narodo/wordclock/face/word_clock_face.pdf

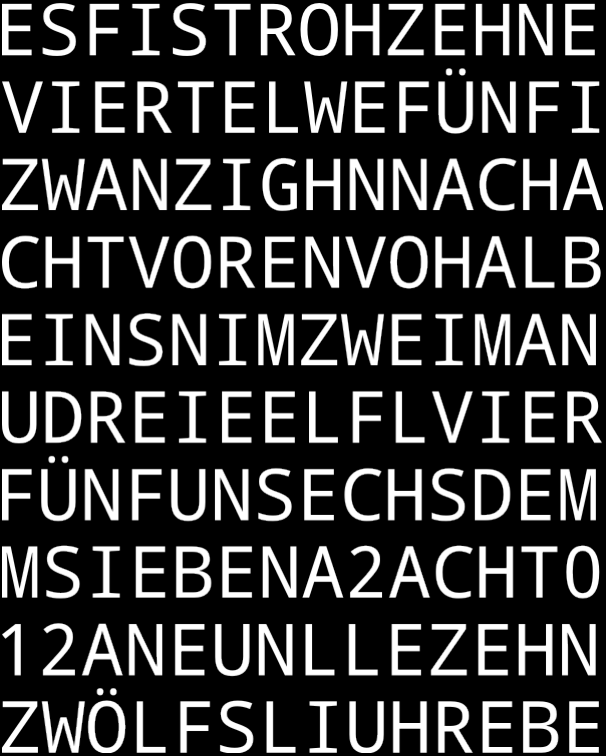
[picture p1: figure]
