narodo/wordclock/face/word_clock_face_template.pdf

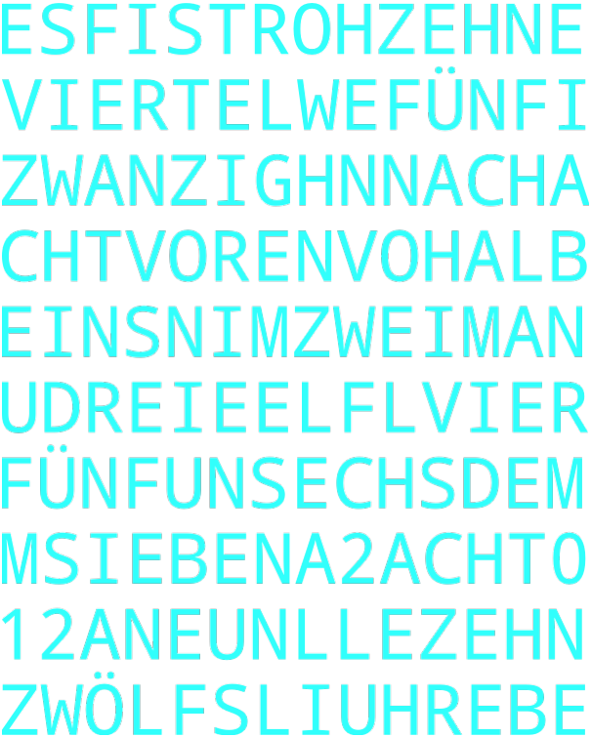
[picture p2: figure]
