narodo/wordclock/face/word_clock_face_colored.pdf

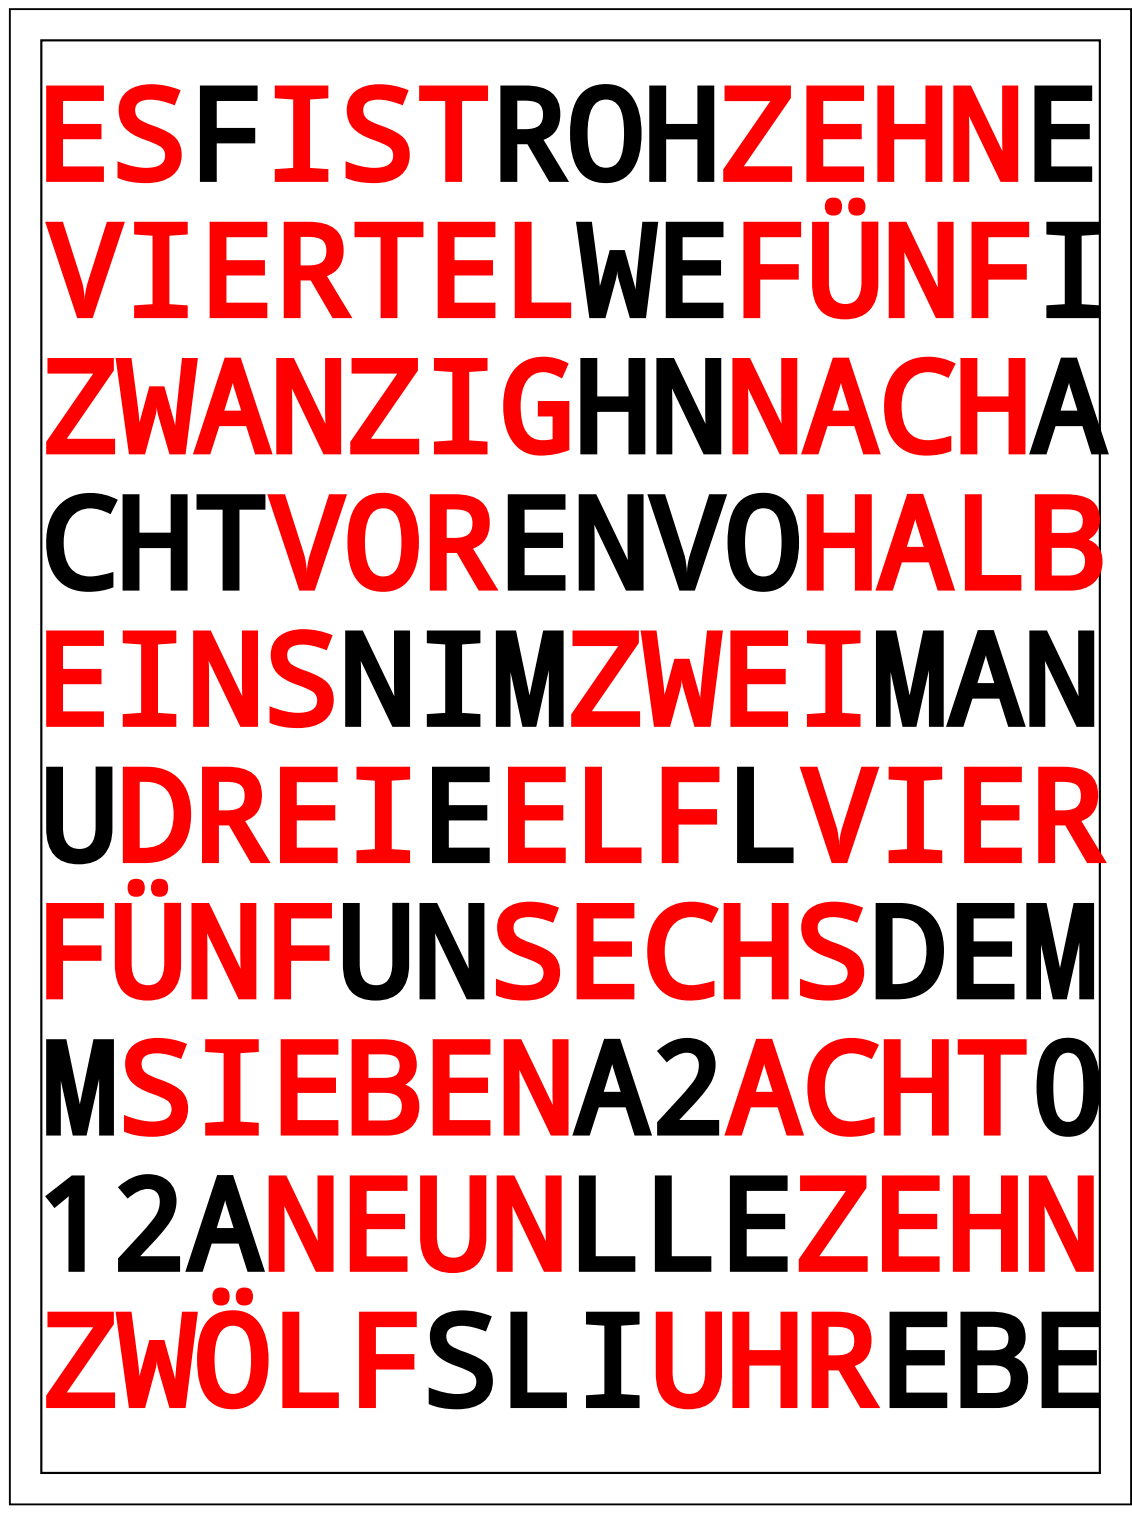
[picture p3: page 1]
