narodo/wordclock/face/word_clock_face_inverted.pdf

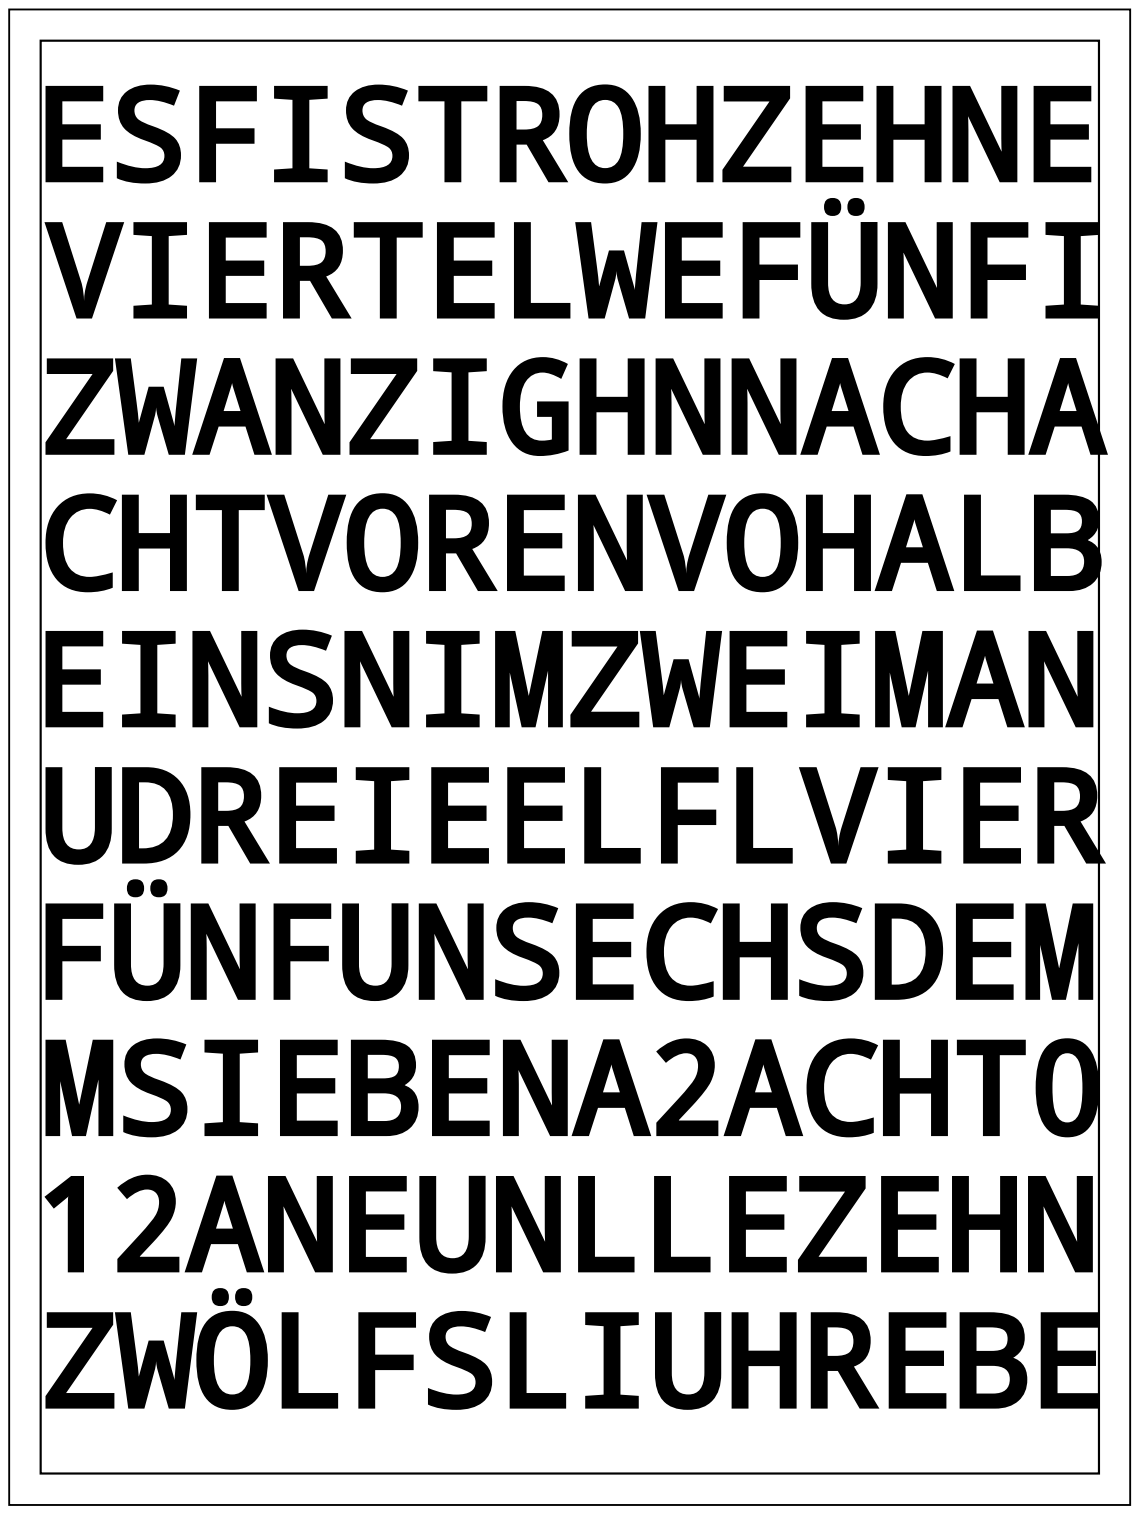
[picture p4: page 1]
