narodo/wordclock/sim/current_mirror/current_mirror.asc

D1: LED; AOT-2015
D2: LED; AOT-2015
D3: LED; AOT-2015
D4: LED; AOT-2015
D5: LED; AOT-2015
D6: LED; AOT-2015
M1: pmos; BSS84
Q1: npn; BC847C
Q2: npn; BC847C
Q3: npn; BC847C
Q4: npn; BC847C
R1: res; 700
R2: res; 100
V1: voltage; 12
V2: voltage; 0
Named nets: 0, VCC, Q4_E
.op
