narodo/wordclock/sim/current_mirror/current_mirror_pmos.asc

D1: LED; AOT-2015
D2: LED; AOT-2015
D3: LED; AOT-2015
D4: LED; AOT-2015
D5: LED; AOT-2015
D6: LED; AOT-2015
D7: LED; AOT-2015
M1: pmos; BSS84
M2: pmos; BSS84
M3: pmos; BSS84
M4: pmos; BSS84
Q1: npn
R1: res; 430
R2: res; 10000
V1: voltage; 12
V2: voltage; 5
Named nets: 0, D1_A, Q1_C
.op
