narodo/wordclock/pcb/word_clock/word_clock.sch

## KiCad design pcb/word_clock/word_clock.sch (2013-01-18)

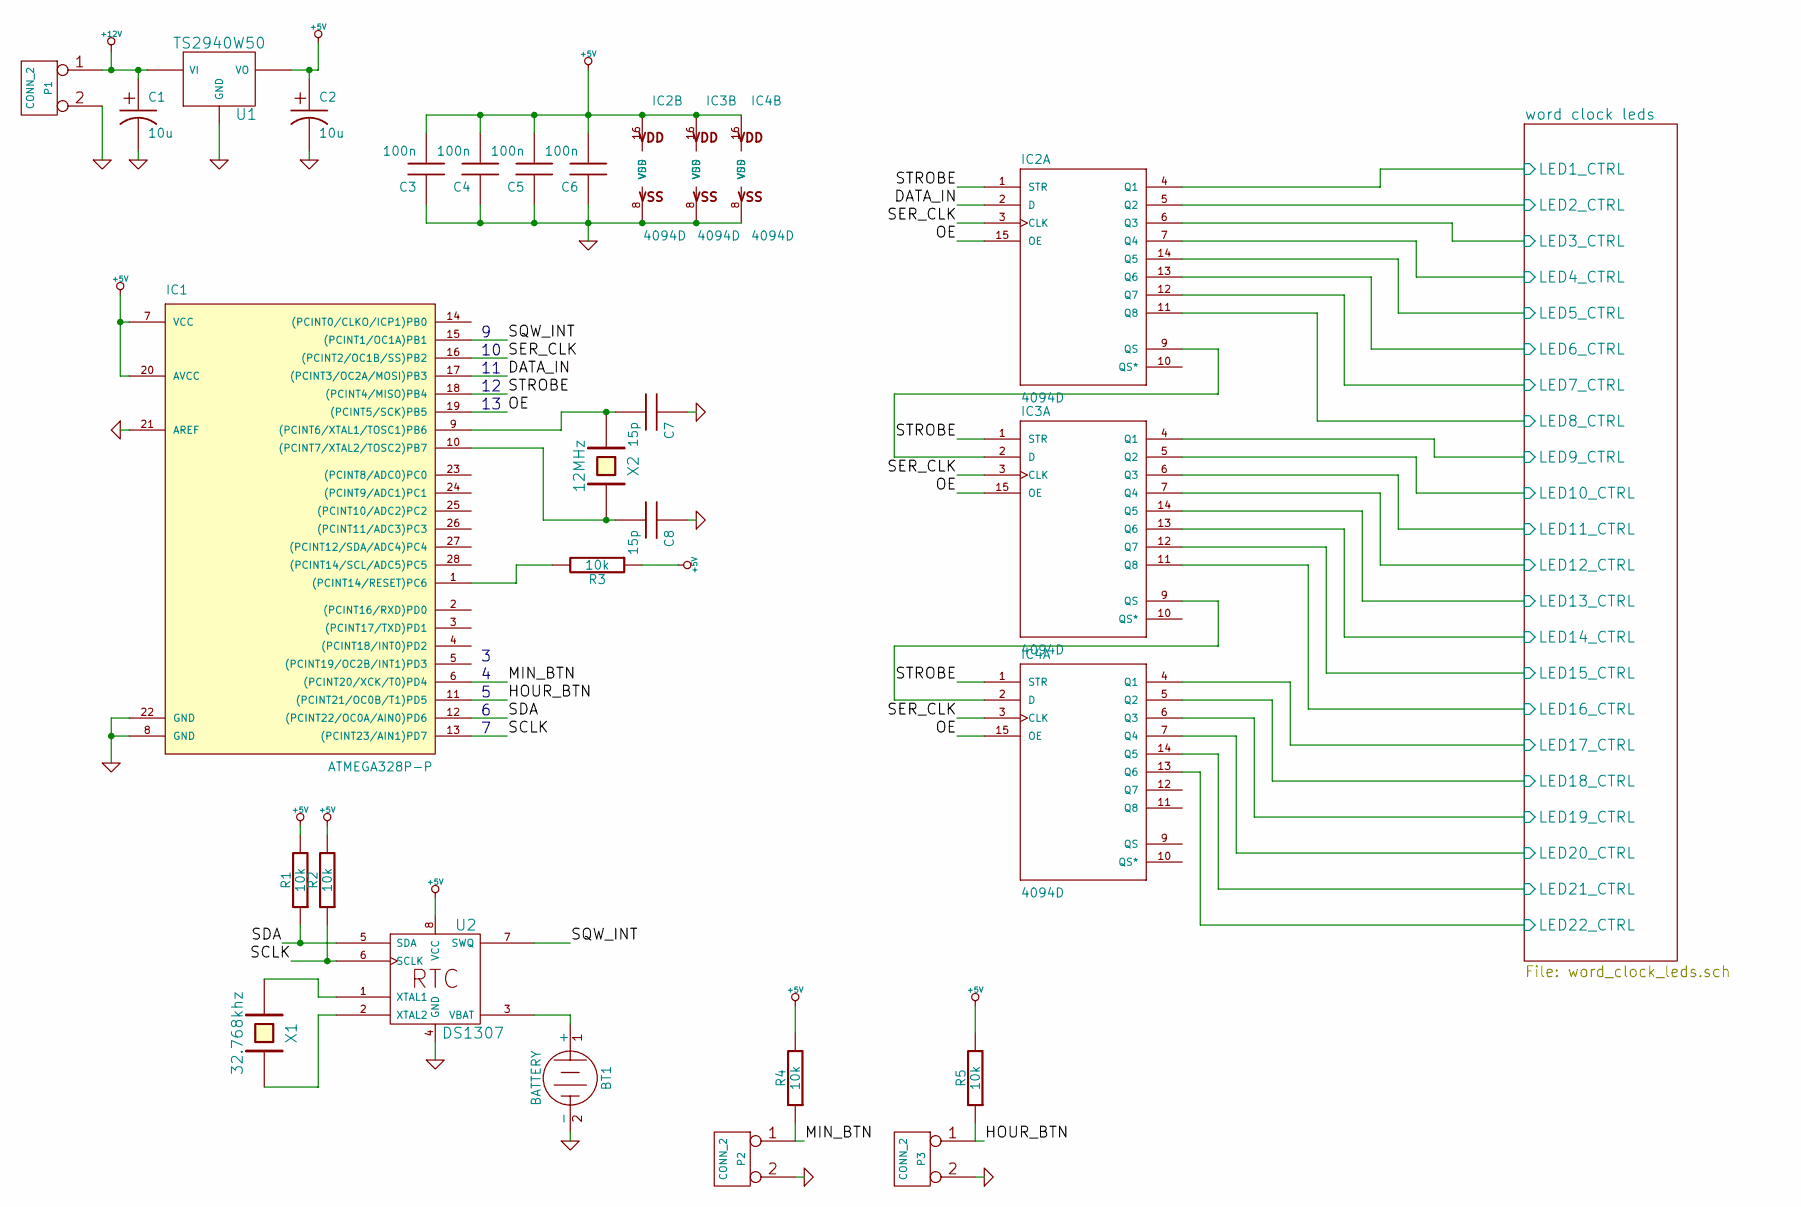
[picture p5: schematic word_clock.sch]

Parts:
BT1: BATTERY
C1, C2: 10u
C3, C4, C5, C6: 100n
C7, C8: 15p
IC1: ATMEGA328P-P; DIL28
IC2, IC3, IC4: 4094D; 40xx-SO16
P1, P2, P3: CONN_2
R1, R2, R3, R4, R5: 10k
U1: TS2940W50
U2: DS1307
X1: 32.768khz
X2: 12MHz

Connections:
+5V: C2.1, C3.2, C4.2, C5.2, C6.2, IC1.7 (VCC), IC1.20 (AVCC), IC2.16 (VDD), IC3.16 (VDD), IC4.16 (VDD), R1.2, R2.2, R3.1, R4.2, R5.2, U1.3 (VO), U2.8 (VCC)
+12V: C1.1, P1.1, U1.1 (VI)
DATA_IN: IC1.17 ((PCINT3/OC2A/MOSI)PB3), IC2.2 (D)
GND: BT1.2 (-), C1.2, C2.2, C3.1, C4.1, C5.1, C6.1, C7.1, C8.1, IC1.8 (GND), IC1.21 (AREF), IC1.22 (GND), IC2.8 (VSS), IC3.8 (VSS), IC4.8 (VSS), P1.2 (PM), P2.2 (PM), P3.2 (PM), U1.2 (GND), U2.4 (GND)
HOUR_BTN: IC1.11 ((PCINT21/OC0B/T1)PD5), P3.1, R5.1
LED1_CTRL: IC2.4 (Q1)
LED2_CTRL: IC2.5 (Q2)
LED3_CTRL: IC2.6 (Q3)
LED4_CTRL: IC2.7 (Q4)
LED5_CTRL: IC2.14 (Q5)
LED6_CTRL: IC2.13 (Q6)
LED7_CTRL: IC2.12 (Q7)
LED8_CTRL: IC2.11 (Q8)
LED9_CTRL: IC3.4 (Q1)
LED10_CTRL: IC3.5 (Q2)
LED11_CTRL: IC3.6 (Q3)
LED12_CTRL: IC3.7 (Q4)
LED13_CTRL: IC3.14 (Q5)
LED14_CTRL: IC3.13 (Q6)
LED15_CTRL: IC3.12 (Q7)
LED16_CTRL: IC3.11 (Q8)
LED17_CTRL: IC4.4 (Q1)
LED18_CTRL: IC4.5 (Q2)
LED19_CTRL: IC4.6 (Q3)
LED20_CTRL: IC4.7 (Q4)
LED21_CTRL: IC4.14 (Q5)
LED22_CTRL: IC4.13 (Q6)
MIN_BTN: IC1.6 ((PCINT20/XCK/T0)PD4), P2.1, R4.1
unnamed: BT1.1 (+), U2.3 (VBAT)
unnamed: C7.2, IC1.9 ((PCINT6/XTAL1/TOSC1)PB6), X2.1
unnamed: C8.2, IC1.10 ((PCINT7/XTAL2/TOSC2)PB7), X2.2
unnamed: IC1.1 ((PCINT14/RESET)PC6), R3.2
unnamed: IC2.9 (QS), IC3.2 (D)
unnamed: IC3.9 (QS), IC4.2 (D)
unnamed: U2.1 (XTAL1), X1.1
unnamed: U2.2 (XTAL2), X1.2
OE: IC1.19 ((PCINT5/SCK)PB5), IC2.15 (OE), IC3.15 (OE), IC4.15 (OE)
SCLK: IC1.13 ((PCINT23/AIN1)PD7), R2.1, U2.6 (SCLK)
SDA: IC1.12 ((PCINT22/OC0A/AIN0)PD6), R1.1, U2.5 (SDA)
SER_CLK: IC1.16 ((PCINT2/OC1B/SS)PB2), IC2.3 (CLK), IC3.3 (CLK), IC4.3 (CLK)
SQW_INT: IC1.15 ((PCINT1/OC1A)PB1), U2.7 (SWQ)
STROBE: IC1.18 ((PCINT4/MISO)PB4), IC2.1 (STR), IC3.1 (STR), IC4.1 (STR)
