narodo/wordclock/pcb/word_clock/word_clock_leds.sch

## KiCad design pcb/word_clock/word_clock_leds.sch (2013-01-18)

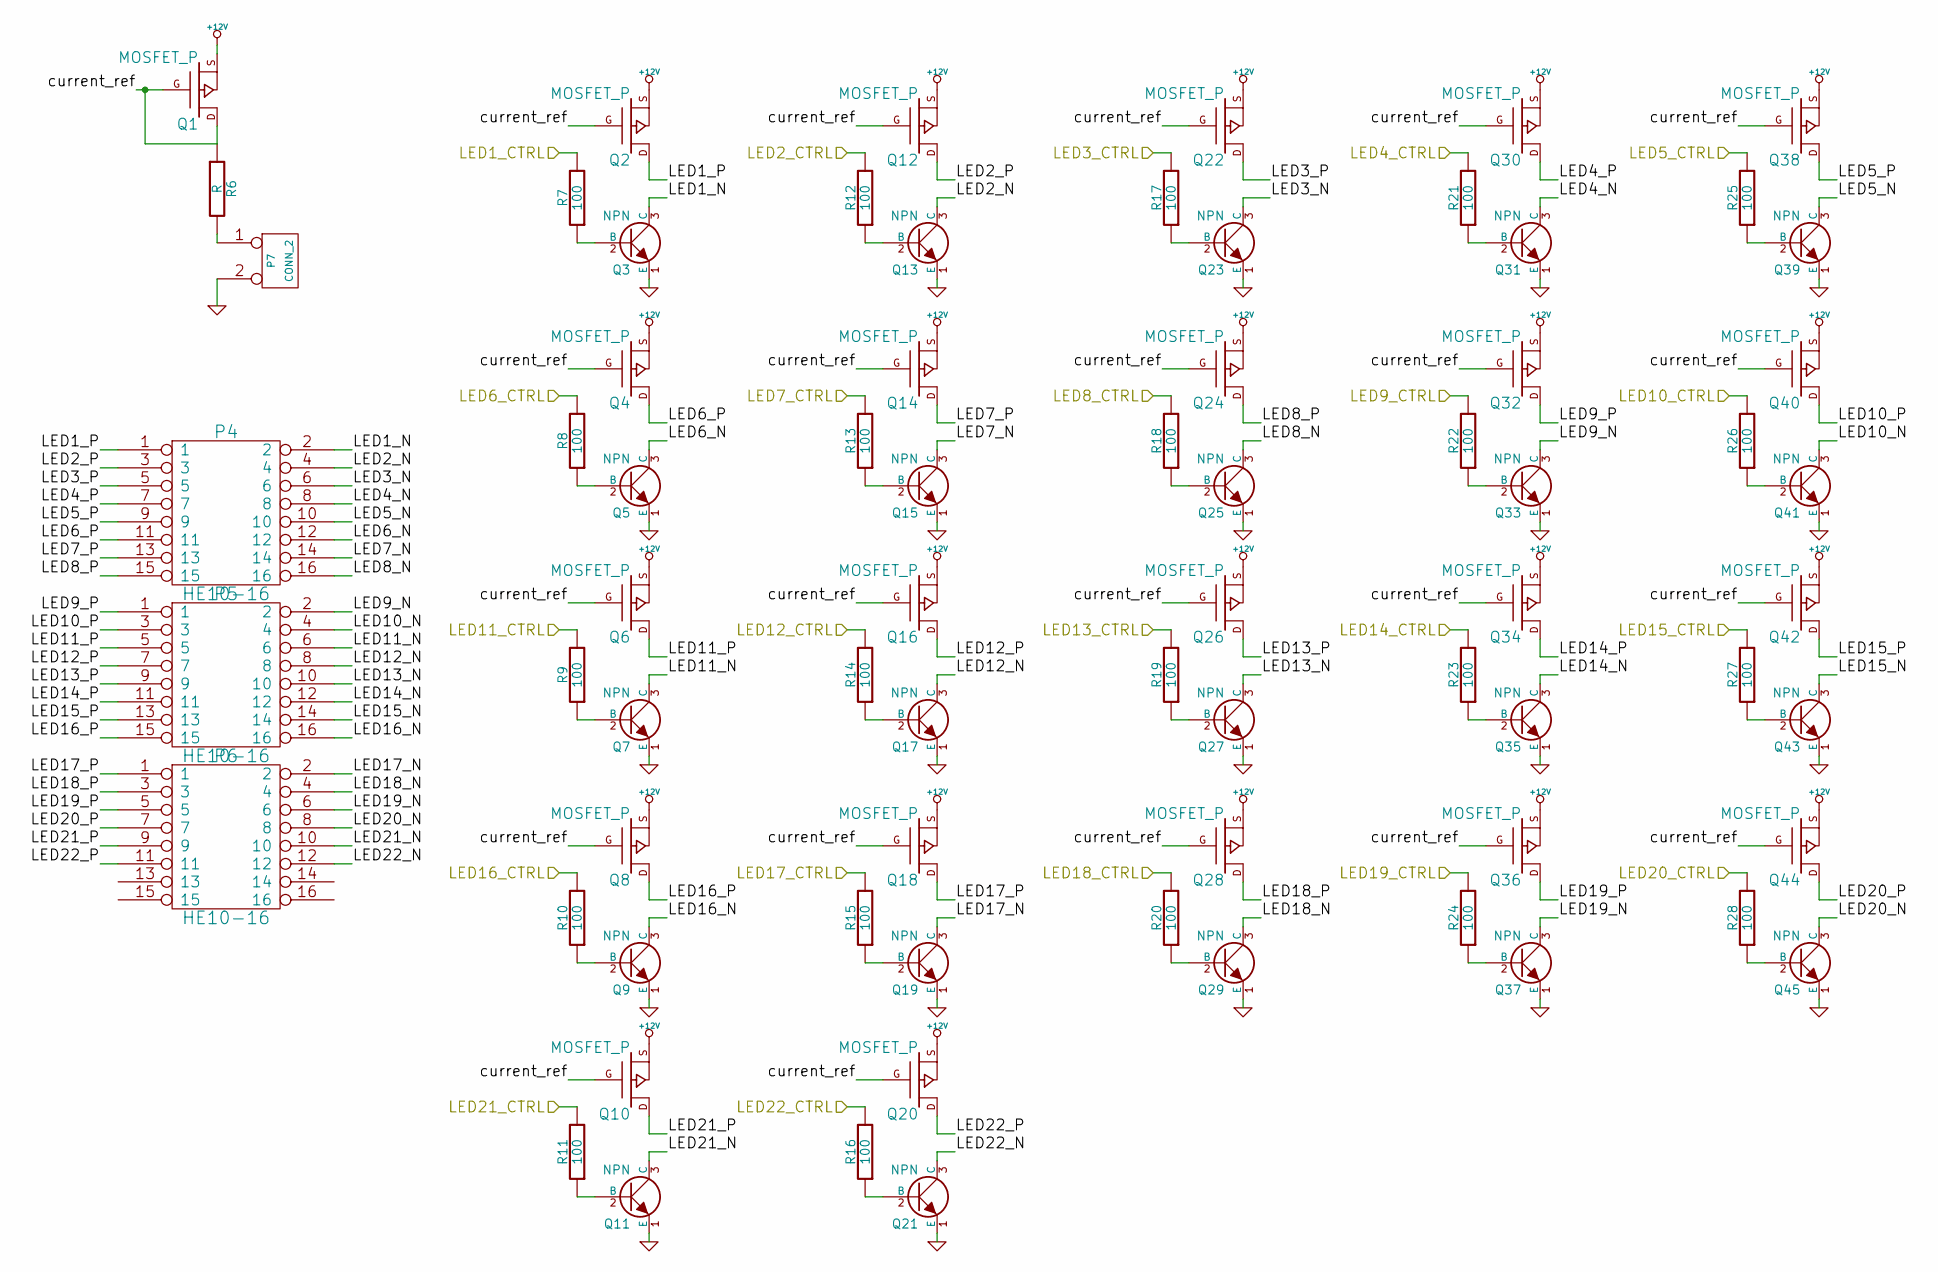
[picture p6: schematic word_clock_leds.sch]

Parts:
P4, P5, P6: HE10-16
P7: CONN_2
Q1, Q2, Q4, Q6, Q8, Q10, Q12, Q14, Q16, Q18, Q20, Q22, Q24, Q26, Q28, Q30, Q32, Q34, Q36, Q38, Q40, Q42, Q44: MOSFET_P
Q3, Q5, Q7, Q9, Q11, Q13, Q15, Q17, Q19, Q21, Q23, Q25, Q27, Q29, Q31, Q33, Q35, Q37, Q39, Q41, Q43, Q45: NPN
R6: R
R7, R8, R9, R10, R11, R12, R13, R14, R15, R16, R17, R18, R19, R20, R21, R22, R23, R24, R25, R26, R27, R28: 100

Connections:
+12V: Q1.S, Q2.S, Q4.S, Q6.S, Q8.S, Q10.S, Q12.S, Q14.S, Q16.S, Q18.S, Q20.S, Q22.S, Q24.S, Q26.S, Q28.S, Q30.S, Q32.S, Q34.S, Q36.S, Q38.S, Q40.S, Q42.S, Q44.S
GND: P7.2 (PM), Q3.1 (E), Q5.1 (E), Q7.1 (E), Q9.1 (E), Q11.1 (E), Q13.1 (E), Q15.1 (E), Q17.1 (E), Q19.1 (E), Q21.1 (E), Q23.1 (E), Q25.1 (E), Q27.1 (E), Q29.1 (E), Q31.1 (E), Q33.1 (E), Q35.1 (E), Q37.1 (E), Q39.1 (E), Q41.1 (E), Q43.1 (E), Q45.1 (E)
LED1_CTRL: R7.2
LED1_N: P4.2, Q3.3 (C)
LED1_P: P4.1, Q2.D
LED2_CTRL: R12.2
LED2_N: P4.4, Q13.3 (C)
LED2_P: P4.3, Q12.D
LED3_CTRL: R17.2
LED3_N: P4.6, Q23.3 (C)
LED3_P: P4.5, Q22.D
LED4_CTRL: R21.2
LED4_N: P4.8, Q31.3 (C)
LED4_P: P4.7, Q30.D
LED5_CTRL: R25.2
LED5_N: P4.10, Q39.3 (C)
LED5_P: P4.9, Q38.D
LED6_CTRL: R8.2
LED6_N: P4.12, Q5.3 (C)
LED6_P: P4.11, Q4.D
LED7_CTRL: R13.2
LED7_N: P4.14, Q15.3 (C)
LED7_P: P4.13, Q14.D
LED8_CTRL: R18.2
LED8_N: P4.16, Q25.3 (C)
LED8_P: P4.15, Q24.D
LED9_CTRL: R22.2
LED9_N: P5.2, Q33.3 (C)
LED9_P: P5.1, Q32.D
LED10_CTRL: R26.2
LED10_N: P5.4, Q41.3 (C)
LED10_P: P5.3, Q40.D
LED11_CTRL: R9.2
LED11_N: P5.6, Q7.3 (C)
LED11_P: P5.5, Q6.D
LED12_CTRL: R14.2
LED12_N: P5.8, Q17.3 (C)
LED12_P: P5.7, Q16.D
LED13_CTRL: R19.2
LED13_N: P5.10, Q27.3 (C)
LED13_P: P5.9, Q26.D
LED14_CTRL: R23.2
LED14_N: P5.12, Q35.3 (C)
LED14_P: P5.11, Q34.D
LED15_CTRL: R27.2
LED15_N: P5.14, Q43.3 (C)
LED15_P: P5.13, Q42.D
LED16_CTRL: R10.2
LED16_N: P5.16, Q9.3 (C)
LED16_P: P5.15, Q8.D
LED17_CTRL: R15.2
LED17_N: P6.2, Q19.3 (C)
LED17_P: P6.1, Q18.D
LED18_CTRL: R20.2
LED18_N: P6.4, Q29.3 (C)
LED18_P: P6.3, Q28.D
LED19_CTRL: R24.2
LED19_N: P6.6, Q37.3 (C)
LED19_P: P6.5, Q36.D
LED20_CTRL: R28.2
LED20_N: P6.8, Q45.3 (C)
LED20_P: P6.7, Q44.D
LED21_CTRL: R11.2
LED21_N: P6.10, Q11.3 (C)
LED21_P: P6.9, Q10.D
LED22_CTRL: R16.2
LED22_N: P6.12, Q21.3 (C)
LED22_P: P6.11, Q20.D
unnamed: P7.1, R6.2
unnamed: Q3.2 (B), R7.1
unnamed: Q5.2 (B), R8.1
unnamed: Q7.2 (B), R9.1
unnamed: Q9.2 (B), R10.1
unnamed: Q11.2 (B), R11.1
unnamed: Q13.2 (B), R12.1
unnamed: Q15.2 (B), R13.1
unnamed: Q17.2 (B), R14.1
unnamed: Q19.2 (B), R15.1
unnamed: Q21.2 (B), R16.1
unnamed: Q23.2 (B), R17.1
unnamed: Q25.2 (B), R18.1
unnamed: Q27.2 (B), R19.1
unnamed: Q29.2 (B), R20.1
unnamed: Q31.2 (B), R21.1
unnamed: Q33.2 (B), R22.1
unnamed: Q35.2 (B), R23.1
unnamed: Q37.2 (B), R24.1
unnamed: Q39.2 (B), R25.1
unnamed: Q41.2 (B), R26.1
unnamed: Q43.2 (B), R27.1
unnamed: Q45.2 (B), R28.1
current_ref: Q1.D, Q1.G, Q2.G, Q4.G, Q6.G, Q8.G, Q10.G, Q12.G, Q14.G, Q16.G, Q18.G, Q20.G, Q22.G, Q24.G, Q26.G, Q28.G, Q30.G, Q32.G, Q34.G, Q36.G, Q38.G, Q40.G, Q42.G, Q44.G, R6.1
