narodo/wordclock/(commit log)

2013-01-14 add arduino sources
2013-01-18 PCB files
    [$savepcb.brd, word_clock.brd, word_clock.sch, word_clock_leds.sch]
2013-01-18 added current mirror simulation files
    [current_mirror.sch]
2013-03-08 added debug info, changed 'leds' to global
2013-03-11 added LED test at start-up
